OpticalMoe/IoT_remote/2.Software/SoftwarePackage/README.md

Github限制单文件大小25MB，可自行在网上搜索“32_package_1.0.6_arduino.cn.exe”，或下载本文件夹下的分卷压缩包（3个）；
