OpticalMoe/IoT_remote/0.Docs/Image/IoT空调线控器.jpg

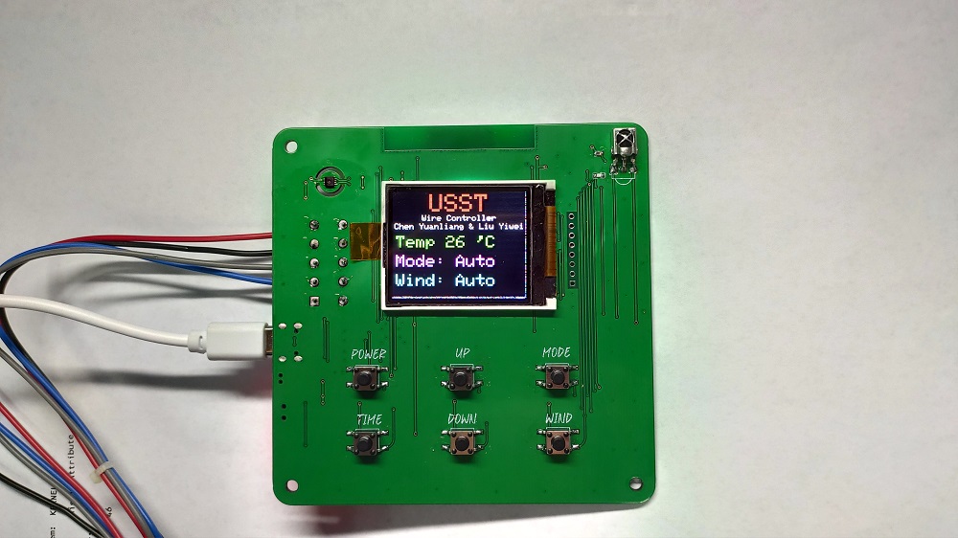
0.Docs/Image/IoT空调线控器.jpg
