OpticalMoe/IoT_remote/0.Docs/Image/智能线控器 (2).jpg

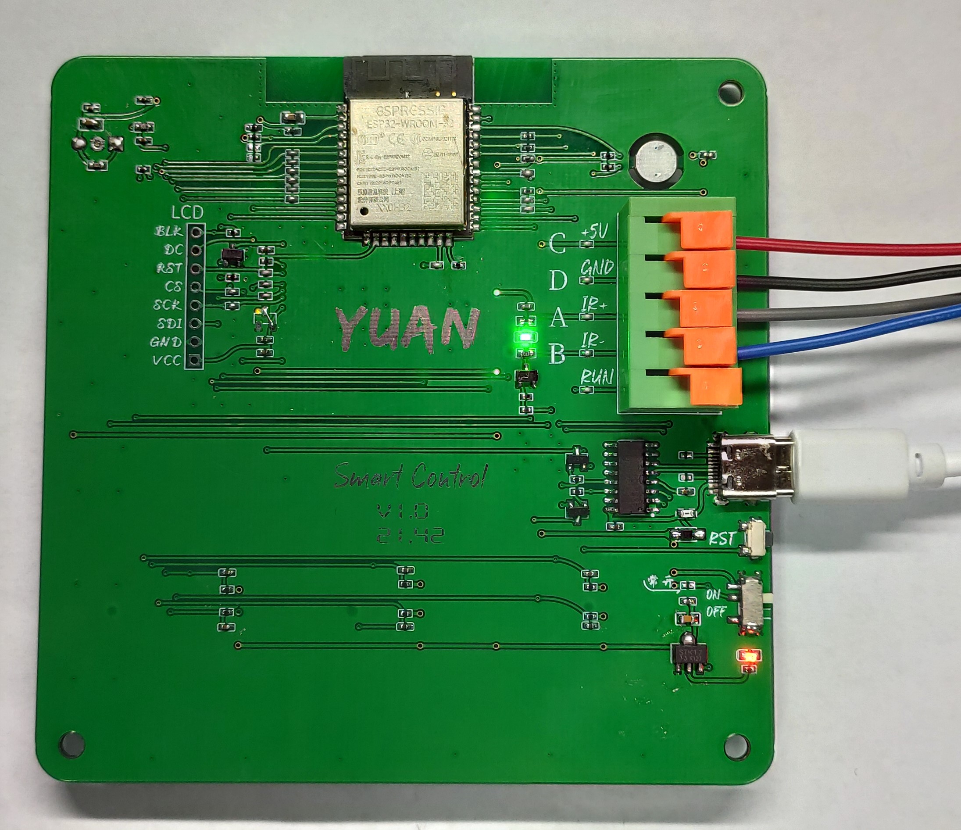
0.Docs/Image/智能线控器 (2).jpg
